ryood/MiniMixer/case/MiniMixerケース内配線.jpg

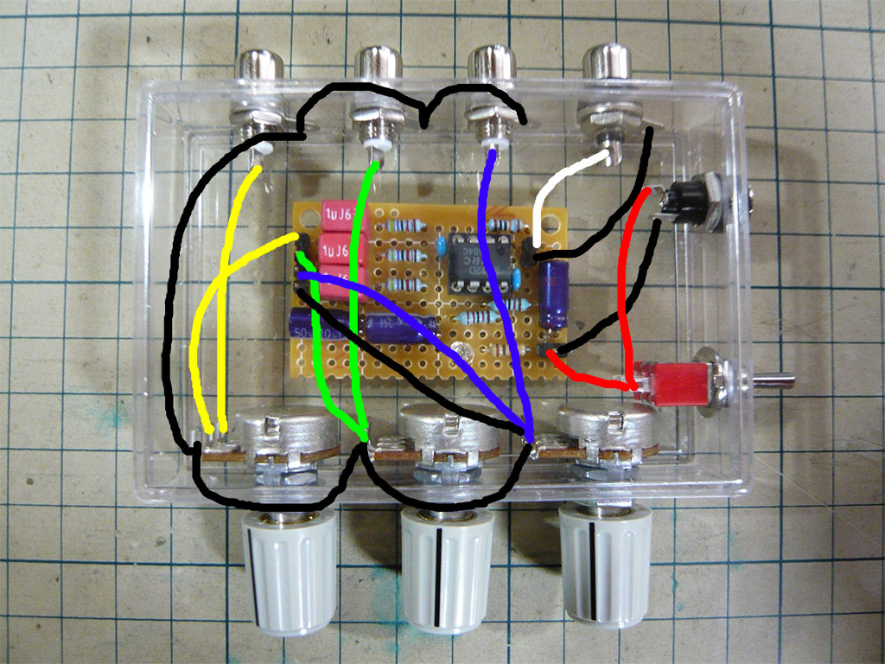
case/MiniMixerケース内配線.jpg
