ryood/MiniMixer/(list of files, cad)

Other CAD files:
case/MiniMixer_Case.dwg
