ryood/MiniMixer/LTSpice/mini_mixer-05.asc

47k: res; 10k
C1: cap; 1u
C2: cap; 1u
C3: cap; 1u
R1: res; 25k
R2: res; 25k
R3: res; 25k
R4: res; 25k
R5: res; 25k
R6: res; 25k
R7: res; 47k
R8: res; 47k
R10: res; 100k
R11: res; {RL}
R13: res; 47
U2: opamp2; njm2732_S
V1: voltage; 2.5V
V2: voltage; -2.5V
V3: voltage; SINE(0 1 1k); AC 1
V4: voltage; SINE(0.2 1 2k)
V5: voltage; SINE(-0.2 1 500)
Named nets: IN1, IN2, IN3, 0, OUT, VCC, VEE
;tran 2m
.ac oct 10 1 100k
.include mylib\
jm2732_2.lib
.step param RL list 1k 10k
