ryood/MiniMixer/(list of files, drawings)

Other design files:
fritzing/mini_mixer-02.fzz
fritzing/mini_mixer.fzz
