ryood/MiniMixer/eagle/Mini-Mixer.brd

## EAGLE design eagle/Mini-Mixer.brd (2015-06-25)

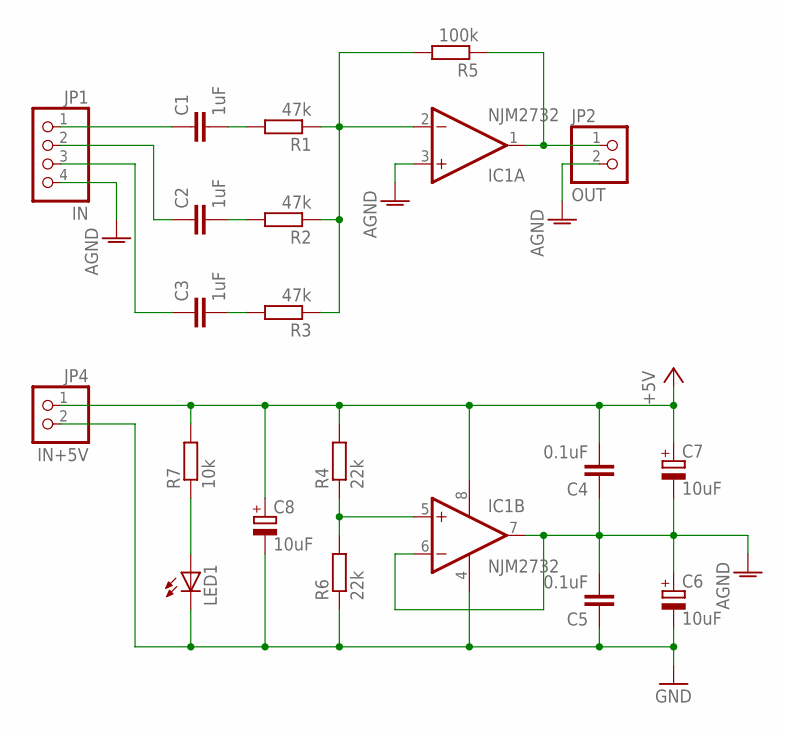
[picture p2: schematic Mini-Mixer.sch]

Parts:
C1, C2, C3: 1uF; C050-050X075
C4, C5: 0.1uF; C025-024X044
C6, C7, C8: 10uF; TT2D4L
IC1: NJM2732; DIL08
JP1: IN; 1X04
JP2: OUT; 1X02
JP4: IN+5V; 1X02
LED1: LED3MM
R1, R2, R3: 47k; 0207/7
R4, R6: 22k; 0207/7
R5: 100k; 0207/7
R7: 10k; 0207/7

Connections:
+5V: C4.2, C7.+, C8.+, IC1.8 (V+), JP4.1, R4.2, R7.2
AGND: C4.1, C5.2, C6.+, C7.-, IC1.3 (+IN), IC1.6 (-IN), IC1.7 (OUT), JP1.4, JP2.2
GND: C5.1, C6.-, C8.-, IC1.4 (V-), JP4.2, LED1.K (C), R6.1
unnamed: C1.1, JP1.1
unnamed: C2.1, JP1.2
unnamed: C3.1, JP1.3
unnamed: C1.2, R1.2
unnamed: C2.2, R2.2
unnamed: C3.2, R3.2
unnamed: IC1.2 (-IN), R1.1, R2.1, R3.1, R5.2
unnamed: LED1.A, R7.1
unnamed: IC1.1 (OUT), JP2.1, R5.1
unnamed: IC1.5 (+IN), R4.1, R6.2

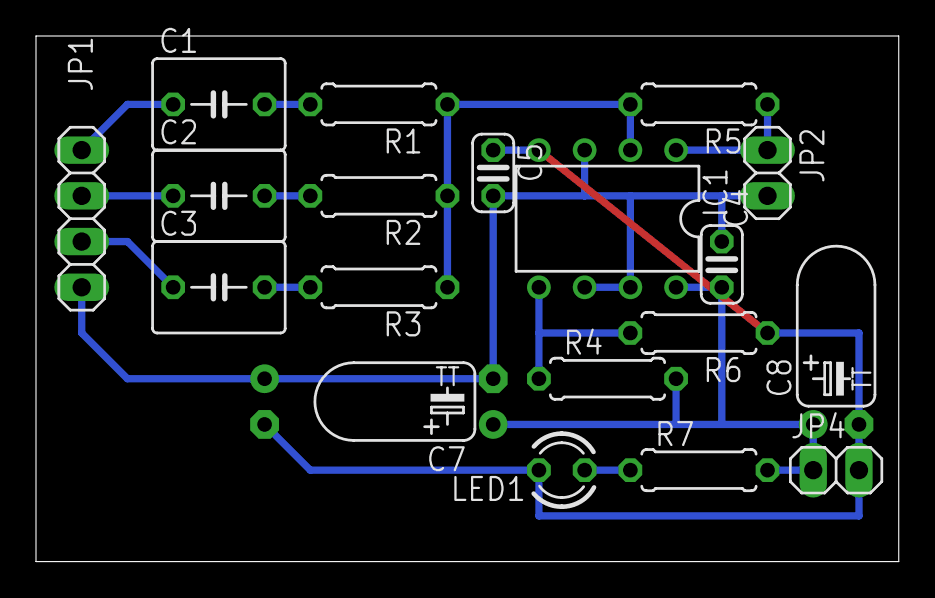
[picture p3: board Mini-Mixer.brd from above]

Board: 2 copper layers, 47.9 x 29.2 mm, 20 parts (1 on the bottom side), 13 nets.
