ryood/MiniMixer/(commit log)

2015-06-25 Board Design Fix
    [Mini-Mixer.brd, Mini-Mixer.sch, mini_mixer-02.fzz]
2015-06-30 case内配線図追加
    [MiniMixer_Case.dwg, MiniMixerテスト表-20150625.xlsx]
